hupfer21/Smart-Meter/readme.md

# Smart Meter

This project is a three-phase smart meter based on the ATM90E36 energy metering IC.

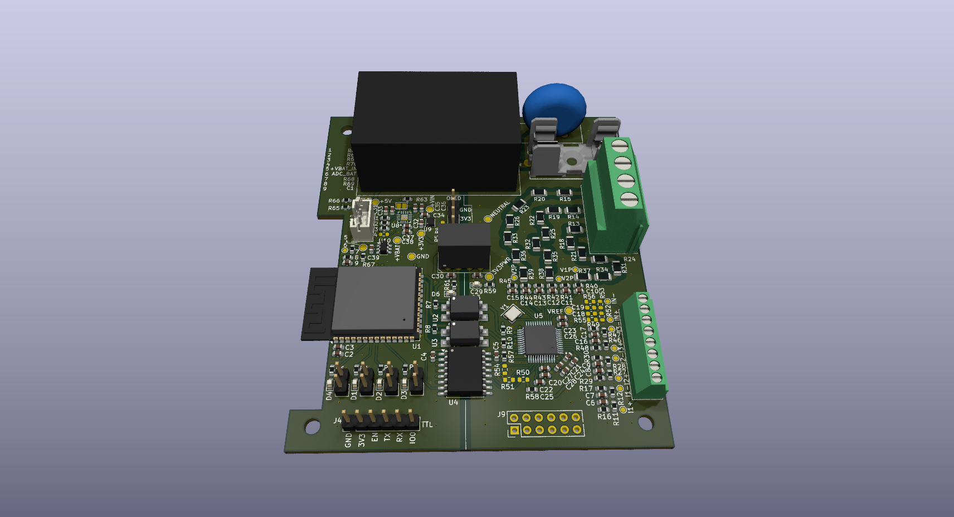
[picture p1: images/PCB_1.png]
PCB 3D Render 1

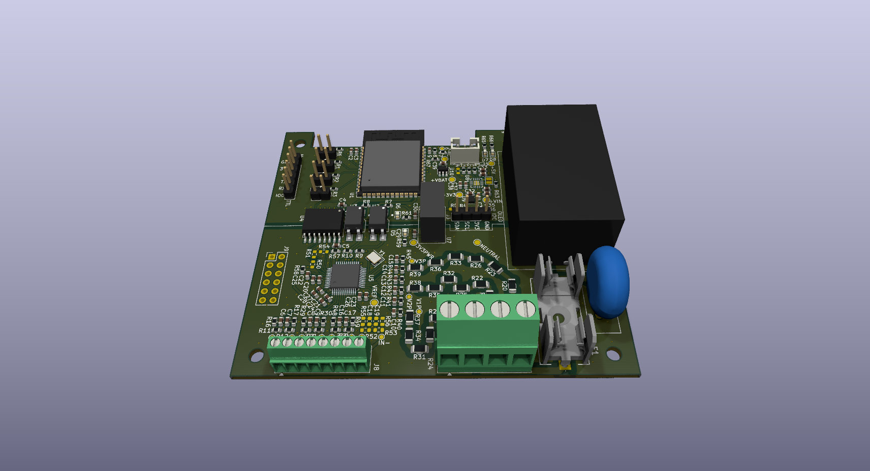
[picture p2: images/PCB_2.png]
PCB 3D Render 2

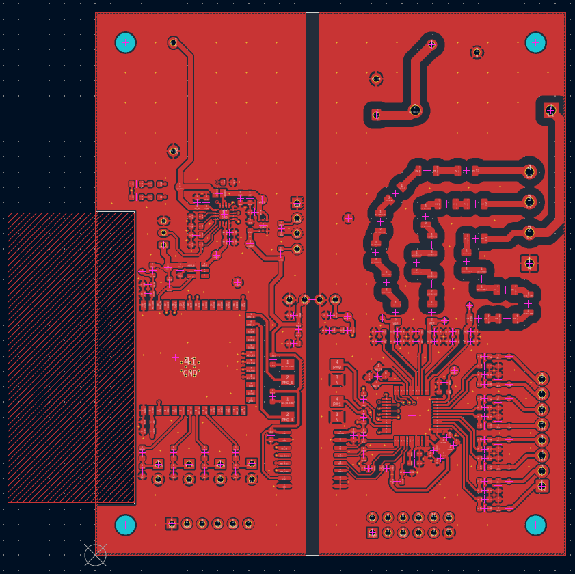
[picture p3: images/PCB_TOP.png]
PCB Top Layer
