hupfer21/Smart-Meter/notes.txt

ALTERAR EXPANSÃO DA MASCARA DE SOLDA DO U5 (ATM90E36)

MD50 embrasul

adicionar botão de configuração

adicionar web page para configuração do wifi?
