hupfer21/Smart-Meter/PCB/myLIB/3D/ATM90E36A-AU-R.stp

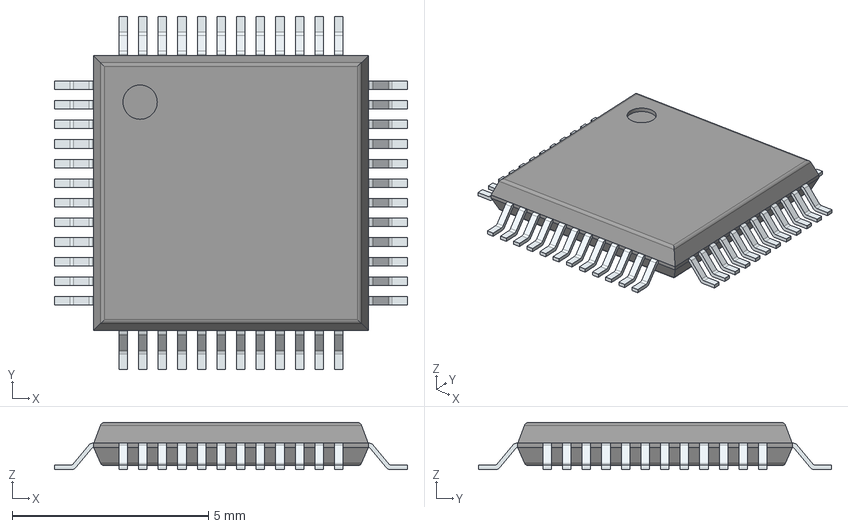
[picture p4: CAD file, 2026-10-03]
PCB/myLIB/3D/ATM90E36A-AU-R.stp
9.00 x 9.00 x 1.20 mm
PinsArrayLR
PinsArrayTB
