hupfer21/Smart-Meter/PCB/myLIB/3D/B_S-1WR3.stp

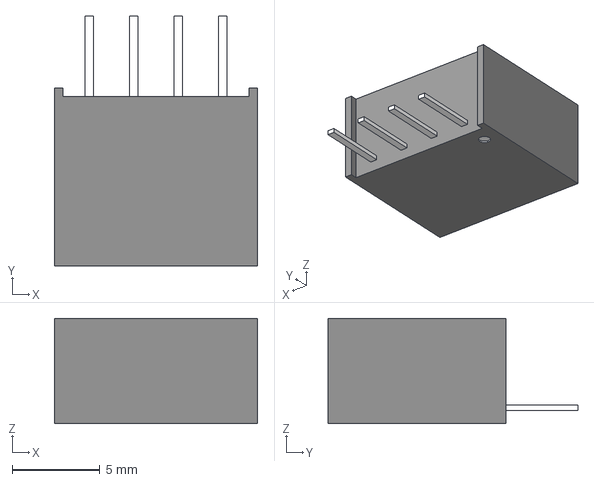
[picture p5: CAD file, 2026-10-03]
PCB/myLIB/3D/B_S-1WR3.stp
11.6 x 14.3 x 6.00 mm
