hupfer21/Smart-Meter/PCB/myLIB/3D/PC817XNNIP1B--3DModel-STEP-56544.STEP

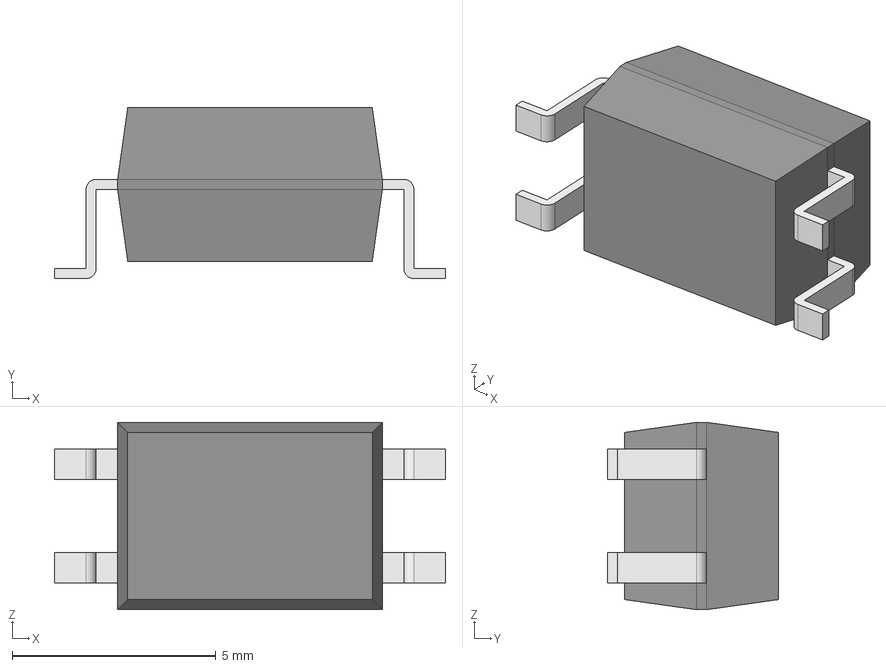
[picture p6: CAD file, 2026-10-03]
PCB/myLIB/3D/PC817XNNIP1B--3DModel-STEP-56544.STEP
9.60 x 4.20 x 4.60 mm
Body001 (Mirror #1) x 2
XY-plane x 12
X-axis x 12
