hupfer21/Smart-Meter/PCB/myLIB/3D/0031.8201.G.stp

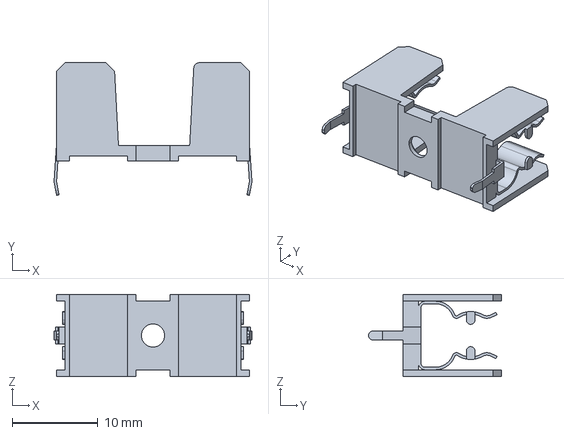
[picture p7: CAD file, 2026-10-03]
PCB/myLIB/3D/0031.8201.G.stp
23.1 x 15.5 x 9.60 mm
