hupfer21/Smart-Meter/PCB/myLIB/3D/Pantalla OLED 0.96'' 128x64.stp

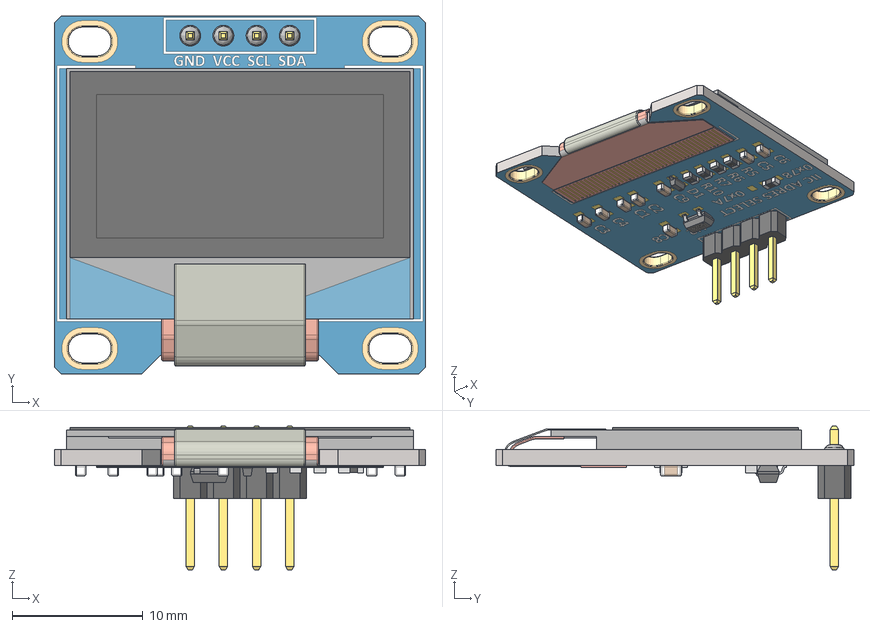
[picture p8: CAD file, 2026-09-03]
PCB/myLIB/3D/Pantalla OLED 0.96'' 128x64.stp
28.4 x 27.4 x 11.0 mm
SOT-23_TOR
RES_CR16_MTK_1 x 4
RES_CR16_MTK
SOD323F_DIO
