hupfer21/Smart-Meter/(list of files, cad)

Other CAD files:
MD50/ESQUEMA_DE_LIGAÇÃO_MD50_FLEX_V01_23.dwg
MD50/ESQUEMA_DE_LIGAÇÃO_MD50-TC_V01_23.dwg
