hupfer21/Smart-Meter/PCB/PCB.kicad_pcb

## KiCad design PCB/PCB.kicad_pcb (2026-10-09)

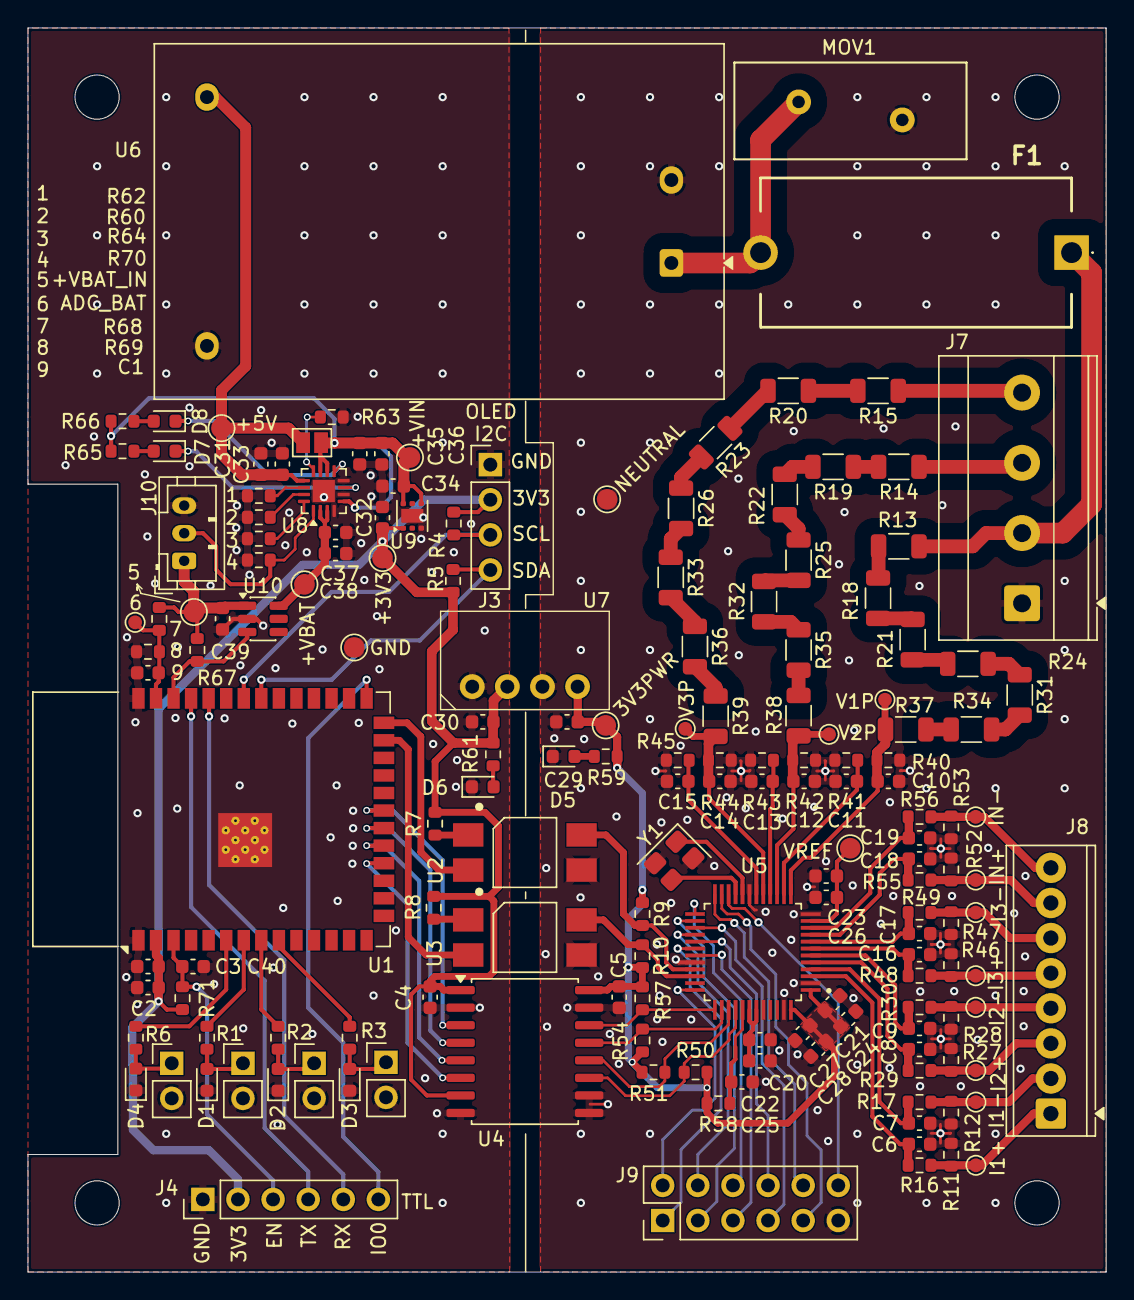
[picture p12: board PCB.kicad_pcb from above]

Board: 2 copper layers, 78.0 x 90.0 mm, 168 parts (0 on the bottom side), 109 nets.

Parts:
C1, C3, C4, C5, C20, C21, C22, C24, C27, C28, C33, C37, C40: 100n/16V; C_0603_1608Metric
C2, C23, C25, C26, C29, C30, C35, C36, C39: 10u/16V; C_0603_1608Metric
C6, C7, C8, C9, C10, C11, C12, C13, C14, C15, C16, C17, C18, C19: 18n/10Q; C_0603_1608Metric
C31, C32, C34, C38: 1u/16V; C_0603_1608Metric
D1: LED_L1; LED_0603_1608Metric
D2: LED_L2; LED_0603_1608Metric
D3, D4: LED_L3; LED_0603_1608Metric
D5, D6, D7, D8: LED; LED_0603_1608Metric
F1: T/200mA/250VAC; FuseHolder_5x20mm_P=22,5mm
H1, H2, H3, H4: MountingHole; MountingHole_3.2mm_M3
J1, J2, J5, J6: Conn_01x02; PinHeader_1x02_P2.54mm_Vertical
J3: Conn_01x04; PinHeader_1x04_P2.54mm_Vertical
J4: Conn_01x06; PinHeader_1x06_P2.54mm_Vertical
J7: Screw_Terminal_01x04; TerminalBlock_Phoenix_MKDS-3-4-5.08_1x04_P5.08mm_Horizontal
J8: Screw_Terminal_01x08; TerminalBlock_Phoenix_MPT-0,5-8-2.54_1x08_P2.54mm_Horizontal
J9: Conn_02x06_Odd_Even; PinHeader_2x06_P2.54mm_Vertical
J10: Conn_01x03; JST_PH_B3B-PH-K_1x03_P2.00mm_Vertical
JP1: SolderJumper_2_Open; SolderJumper-2_P1.3mm_Open_Pad1.0x1.5mm
MOV1: 14D471K; RV_Disc_D16.5mm_W6.7mm_P7.5mm
R1, R2, R3, R6, R7, R8, R59, R61, R65, R66: 1k; R_0603_1608Metric
R4, R5, R9, R10, R50, R51, R54, R57, R58, R67, R68, R69, R70, R71: 10k; R_0603_1608Metric
R11, R12, R27, R28, R46, R47, R52, R53: 2R4/1Q; R_0603_1608Metric
R13, R14, R15, R18, R19, R20, R21, R22, R23, R24, R25, R26, R31, R32, R33, R34, R35, R36, R37, R38, R39: 240k/1Q; R_1206_3216Metric
R16, R17, R29, R30, R40, R41, R42, R43, R44, R45, R48, R49, R55, R56: 1k/1Q; R_0603_1608Metric
R60: 91R/1Q; R_0603_1608Metric
R62: 56k/1Q; R_0603_1608Metric
R63: 1k58/1Q; R_0603_1608Metric
R64: 1k8/1Q; R_0603_1608Metric
TP1, TP13, TP14, TP15, TP16, TP17, TP18, TP19, TP21: TestPoint; TestPoint_Pad_D1.5mm
TP2, TP3, TP4, TP5, TP6, TP7, TP8, TP9, TP10, TP11, TP12, TP20: TestPoint; TestPoint_Pad_D1.0mm
U1: ESP32-S3; ESP32-S3-WROOM-1
U2, U3: PC817; SOIC-4_6.5x4.6_P2.54mm
U4: ADuM1411; SOIC-16W_7.5x10.3mm_P1.27mm
U5: ATM90E36A-AU-R; 48TQFP
U6: HLK-5M05; Converter_ACDC_Hi-Link_HLK-5Mxx
U7: B0303S-1WR3
U8: BQ24073RGT; VQFN-16-1EP_3x3mm_P0.5mm_EP1.6x1.6mm
U9: TLV75733PDRV; WSON-6-1EP_2x2mm_P0.65mm_EP1x1.6mm
U10: TPS22918DBV; SOT-23-6
Y1: ABM8W-16.3840MHZ-4-B1U-T3; Crystal_SMD_3225-4Pin_3.2x2.5mm

Connections:
+3V3: C2.1, C3.1, C4.1, C30.1, C32.1, J3.2, J4.2, R4.1, R5.1, R7.1, R8.1, R61.1, R71.1, TP16.1 (1_1), U1.2 (3V3), U4.1 (VDD1), U4.7 (CTRL1), U7.2 (+Vin), U9.1 (OUT)
+3V3PWR: C5.1, C21.1, C24.1, C27.1, C28.1, C29.1, R9.1, R10.1, R50.1, R51.1, R54.1, R57.1, R58.1, R59.1, TP14.1 (1_1), U4.16 (VDD2), U5.1 (AVDD), U5.48 (DVDD), U7.4 (+Vout)
+5V_EXT: C31.1, C33.1, JP1.1 (A), TP15.1 (1_1), U6.4 (+Vout), U8.13 (IN)
+VBAT: C37.1, C38.1, TP18.1 (1_1), U8.2 (BAT), U8.3 (BAT), U10.6 (VOUT)
+VBAT_IN: C39.1, J10.1, R67.1, R68.1, TP19.1 (1_1), U10.1 (VIN)
+VIN: C34.1, C35.1, C36.1, JP1.2 (B), R65.1, R66.1, TP17.1 (1_1), U8.5 (EN2), U8.10 (OUT), U8.11 (OUT), U9.4 (EN), U9.6 (IN)
/CF1: J9.6, U5.25 (CF1)
/CF2: J9.3, U5.26 (CF2)
/CF3: J9.7, U5.27 (CF3)
/CF4: J9.4, U5.28 (CF4)
/CHG: D8.1 (K), U8.9 (~CHG)
/DMA: J9.2, U5.36 (DMA_CTRL)
/EN: C40.1, J4.3, R71.2, U1.3 (EN)
/I1N: C7.2, R17.2, U5.4 (I1N)
/I1P: C6.1, R16.2, U5.3 (I1P)
/I2N: C9.2, R30.2, U5.6 (I2N)
/I2P: C8.1, R29.2, U5.5 (I2P)
/I3N: C17.2, R49.2, U5.8 (I3N)
/I3P: C16.1, R48.2, U5.7 (I3P)
/I4N: C19.2, R56.2, U5.10 (I4N)
/I4P: C18.1, R55.2, U5.9 (I4P)
/ILIM: R63.1, U8.12 (ILIM)
/IO0: J4.6, U1.27 (IO0)
/IRQ0: J9.1, U5.30 (IRQ0)
/IRQ1: J9.5, U5.31 (IRQ1)
/ISET: R64.1, U8.16 (ISET)
/LED_L1: R1.1, U1.7 (IO7)
/LED_L2: R2.1, U1.8 (IO15)
/LED_L3: R3.1, U1.9 (IO16)
/LED_WIFI: R6.1, U1.6 (IO6)
/MCU_CS: U1.21 (IO13), U4.3 (VIA)
/MCU_MISO: U1.18 (IO10), U4.6 (VOD)
/MCU_MOSI: U1.19 (IO11), U4.5 (VIC)
/MCU_SCLK: U1.20 (IO12), U4.4 (VIB)
/OSCI: U5.20 (OSCI), Y1.1
/OSCO: U5.21 (OSCO), Y1.3
/PG: D7.1 (K), U8.7 (~PGOOD)
/PMC_0: U1.26 (IO45), U2.2
/PMC_1: U1.25 (IO48), U3.2
/RXD0: J4.5, U1.36 (RXD0)
/SCL: J3.3, R4.2, U1.34 (IO41)
/SDA: J3.4, R5.2, U1.33 (IO40)
/TD: R60.1, U8.15 (TD)
/TMR: R62.1, U8.14 (TMR)
/TS: J10.2, R70.1, U8.1 (TS)
/TXD0: J4.4, U1.37 (TXD0)
/V1N: C11.2, R41.1, U5.14 (V1N)
/V1P: C10.1, R37.2, R40.2, TP8.1 (1_1), U5.13 (V1P)
/V2N: C13.2, R43.1, U5.16 (V2N)
/V2P: C12.1, R38.2, R42.2, TP9.1 (1_1), U5.15 (V2P)
/V3N: C15.2, R45.1, U5.18 (V3N)
/V3P: C14.1, R39.2, R44.2, TP10.1 (1_1), U5.17 (V3P)
/VREF: C23.1, C26.1, TP13.1 (1_1), U5.11 (VREF)
/WARN: J9.8, U5.29 (WARNOUT)
/ZX0: J9.12, U5.22 (ZX0)
/ZX1: J9.9, U5.23 (ZX1)
/ZX2: J9.10, U5.24 (ZX2)
ADC_BAT: C1.1, R68.2, R69.1, TP20.1 (1_1), U1.39 (IO1)
BAT_SW: R67.2, U1.38 (IO2), U10.3 (ON)
GND: C1.2, C2.2, C3.2, C4.2, C30.2, C31.2, C32.2, C33.2, C34.2, C35.2, C36.2, C37.2, C38.2, C39.2, C40.2, D1.1 (K), D2.1 (K), D3.1 (K), D4.1 (K), D6.1 (K), J1.2, J2.2, J3.1, J4.1, J5.2, J6.2, J10.3, R60.2, R62.2, R63.2, R64.2, R69.2, R70.2, TP21.1 (1_1), U1.1 (GND), U1.40 (GND), U1.41 (GND), U4.2 (GND1), U4.8 (GND1), U6.3 (-Vout), U7.1 (-Vin), U8.4 (~CE), U8.6 (EN1), U8.8 (VSS), U8.17 (VSS), U9.3 (GND), U9.7 (GND), U10.2 (GND)
I1+: J8.1, R11.2, R16.1, TP2.1 (1_1)
I1-: J8.2, R12.1, R17.1, TP3.1 (1_1)
I2+: J8.3, R27.2, R29.1, TP4.1 (1_1)
I2-: J8.4, R28.1, R30.1, TP5.1 (1_1)
I3+: J8.5, R46.2, R48.1, TP6.1 (1_1)
I3-: J8.6, R47.1, R49.1, TP7.1 (1_1)
IN+: J8.7, R52.2, R55.1, TP11.1 (1_1)
IN-: J8.8, R53.1, R56.1, TP12.1 (1_1)
L1: F1.1, J7.2, R13.1
L2: J7.3, R14.1
L3: J7.4, R15.1
MISO: R50.2, U4.11 (VID), U5.40 (SDI)
MOSI: R51.2, U4.12 (VOC), U5.39 (SD0)
N: C5.2, C6.2, C7.1, C8.2, C9.1, C10.2, C11.1, C12.2, C13.1, C14.2, C15.1, C16.2, C17.1, C18.2, C19.1, C20.2, C21.2, C22.2, C23.2, C24.2, C25.2, C26.2, C27.2, C28.2, C29.2, D5.1 (K), J7.1, J9.11, MOV1.2, R11.1, R12.2, R27.1, R28.2, R40.1, R41.2, R42.1, R43.2, R44.1, R45.2, R46.1, R47.2, R52.1, R53.2, TP1.1 (1_1), U2.3, U3.3, U4.9 (GND2), U4.10 (CTRL2), U4.15 (GND2), U5.2 (AGND), U5.12 (AGND), U5.19 (DGND), U5.32 (TEST), U5.44 (DGND), U5.47 (DGND), U6.2 (AC/N), U7.3 (-Vout), Y1.2 (G), Y1.4 (G)
unnamed: D1.2 (A), J1.1, R1.2
unnamed: D2.2 (A), J2.1, R2.2
unnamed: D3.2 (A), J5.1, R3.2
unnamed: D4.2 (A), J6.1, R6.2
unnamed: D5.2 (A), R59.2
unnamed: D6.2 (A), R61.2
unnamed: D7.2 (A), R65.2
unnamed: D8.2 (A), R66.2
unnamed: R7.2, U2.1
unnamed: R8.2, U3.1
unnamed: R13.2, R18.1
unnamed: R14.2, R19.1
unnamed: R15.2, R20.1
unnamed: R18.2, R21.1
unnamed: R19.2, R22.1
unnamed: R20.2, R23.1
unnamed: R21.2, R24.1
unnamed: R22.2, R25.1
unnamed: R23.2, R26.1
unnamed: R24.2, R31.1
unnamed: R25.2, R32.1
unnamed: R26.2, R33.1
unnamed: R31.2, R34.1
unnamed: R32.2, R35.1
unnamed: R33.2, R36.1
unnamed: R34.2, R37.1
unnamed: R35.2, R38.1
unnamed: R36.2, R39.1
unnamed: C20.1, R58.2, U5.41 (~RESET)
unnamed: F1.2, MOV1.1, U6.1 (AC/L)
PM0: R9.2, U2.4, U5.33 (PM0)
PM1: R10.2, U3.4, U5.34 (PM1)
SCLK: R54.2, U4.13 (VOB), U5.38 (SCLK)
VDD18: C22.1, C25.1, U5.42 (VDD18), U5.43 (VDD18)
~CS: R57.2, U4.14 (VOA), U5.37 (~CS)
