hupfer21/Smart-Meter/(commit log)

2026-09-02 addded oled screen and wifi led
    [digital.kicad_sch, energy_metering.kicad_sch, isolation.kicad_sch]
2026-09-03 added md50 eschema
    [ESQUEMA_DE_LIGAÇÃO_MD50-TC_V01_23.dwg, ESQUEMA_DE_LIGAÇÃO_MD50_FLEX_V01_23.dwg]
2026-09-03 added MD50 PDFs and oled 3d model
    [Pantalla OLED 0.96'' 128x64.stp, energy_metering.kicad_sch, isolation.kicad_sch]
2026-09-04 edited the PCB layout
    [PCB.kicad_pcb, digital.kicad_sch, energy_metering.kicad_sch, isolation.kicad_sch]
2026-09-09 PCB routing and adjusts
    [PCB.kicad_pcb, digital.kicad_sch, energy_metering.kicad_sch, isolation.kicad_sch]
2026-09-09 altered the solder mask expansion and added pcb cutout under esp antenna
    [PCB.kicad_pcb, digital.kicad_sch, energy_metering.kicad_sch, isolation.kicad_sch]
2026-09-14 added cutout for esp antenna
    [PCB.kicad_pcb]
2026-09-27 finished layout, added gerber files, added BOM
    [PCB-B_Cu.gbr, PCB-B_Mask.gbr, PCB-B_Paste.gbr, PCB-B_Silkscreen.gbr, PCB-Edge_Cuts.gbr, PCB-F_Cu.gbr, PCB-F_Mask.gbr, PCB-F_Paste.gbr]
2026-10-03 new readme, added .step models to pcb
    [0031.8201.G.stp, ATM90E36A-AU-R.stp, B_S-1WR3.stp, PC817XNNIP1B--3DModel-STEP-56544.STEP, PCB.kicad_pcb, isolation.kicad_sch]
2026-10-05 exported schematics as pdf
2026-10-09 added pullup resistor on EN pin + cap to gnd on the same pin
